mlehmann76/valvecontrol/hardware/revb/pdf/esp32control-B_Cu.pdf

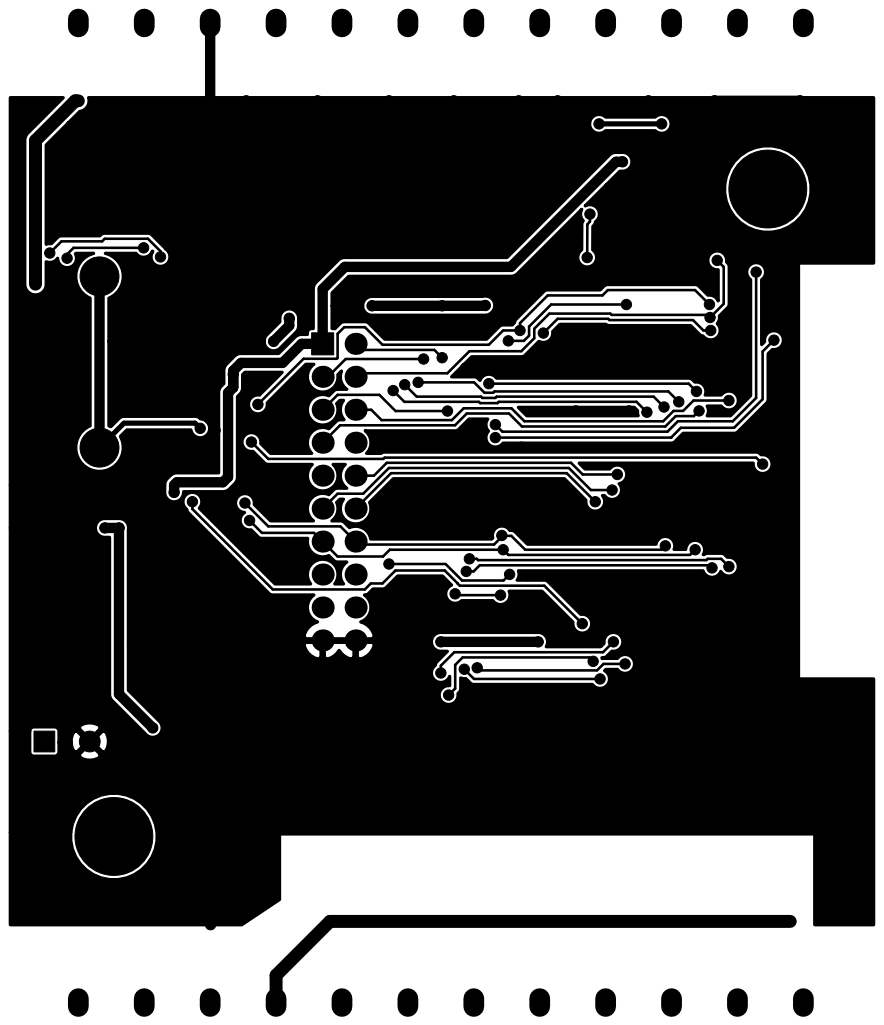
[picture p1: page 1]
