mlehmann76/valvecontrol/hardware/revb/pdf/esp32control-B_Mask.pdf

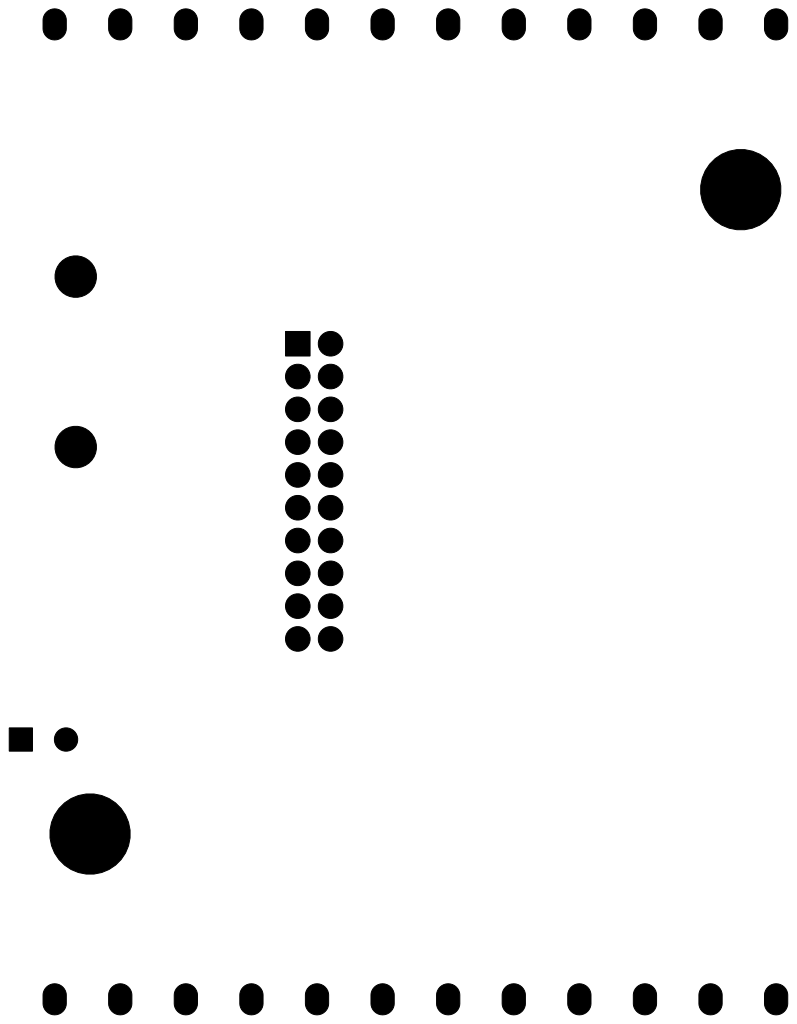
[picture p2: page 1]
