mlehmann76/valvecontrol/hardware/revb/pdf/esp32control-F_Cu.pdf

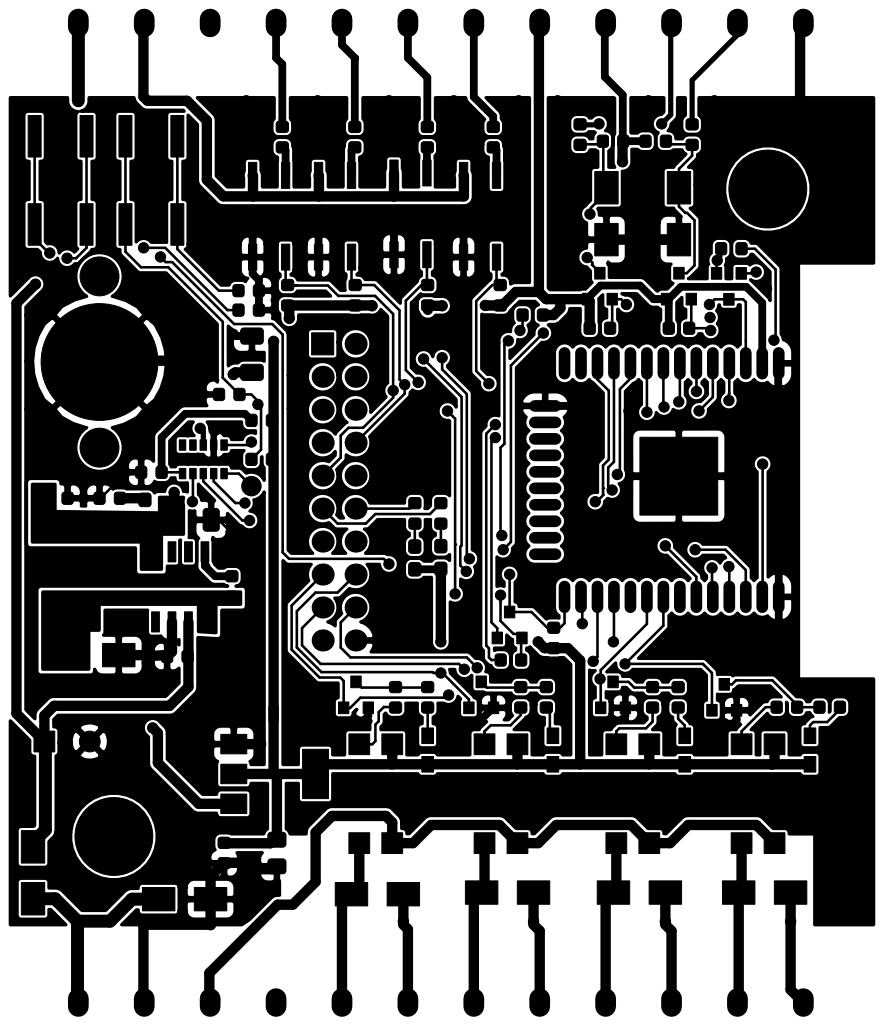
[picture p3: page 1]
