mlehmann76/valvecontrol/hardware/revb/pdf/esp32control-F_Mask.pdf

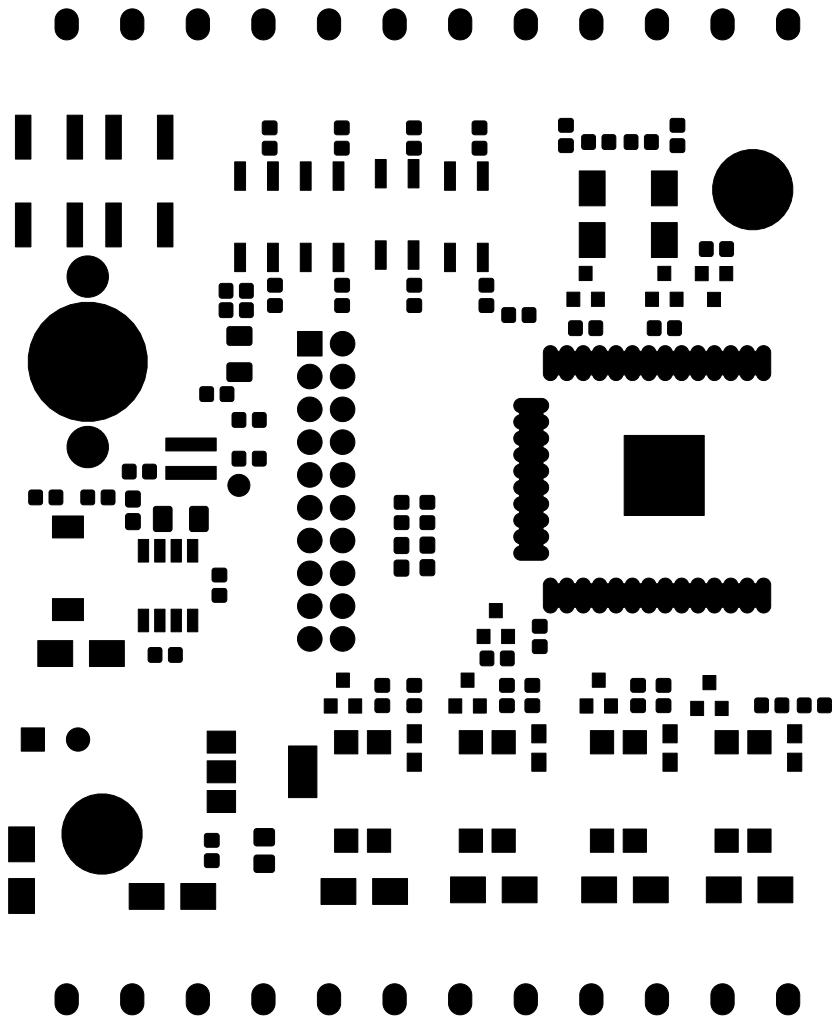
[picture p4: page 1]
