mlehmann76/valvecontrol/hardware/revb/pdf/esp32control-F_Paste.pdf

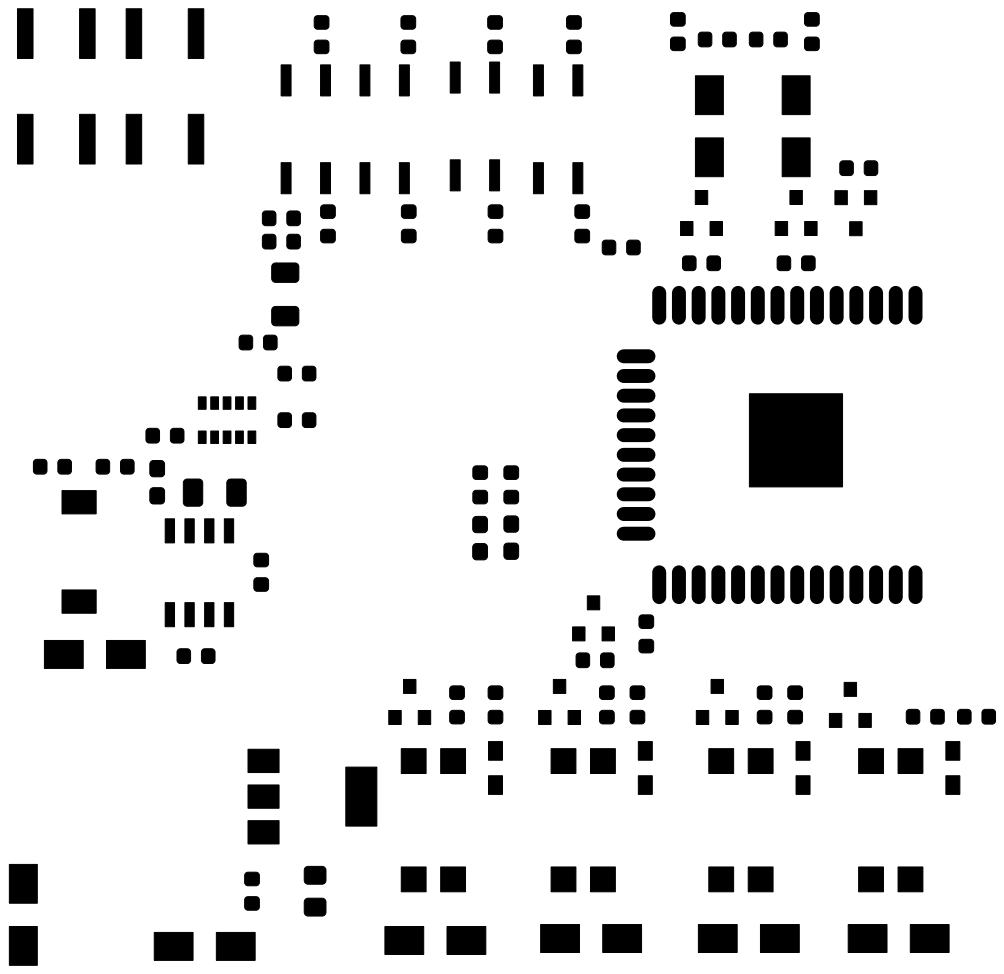
[picture p5: page 1]
