mlehmann76/valvecontrol/hardware/revb/pdf/esp32control-F_SilkS.pdf

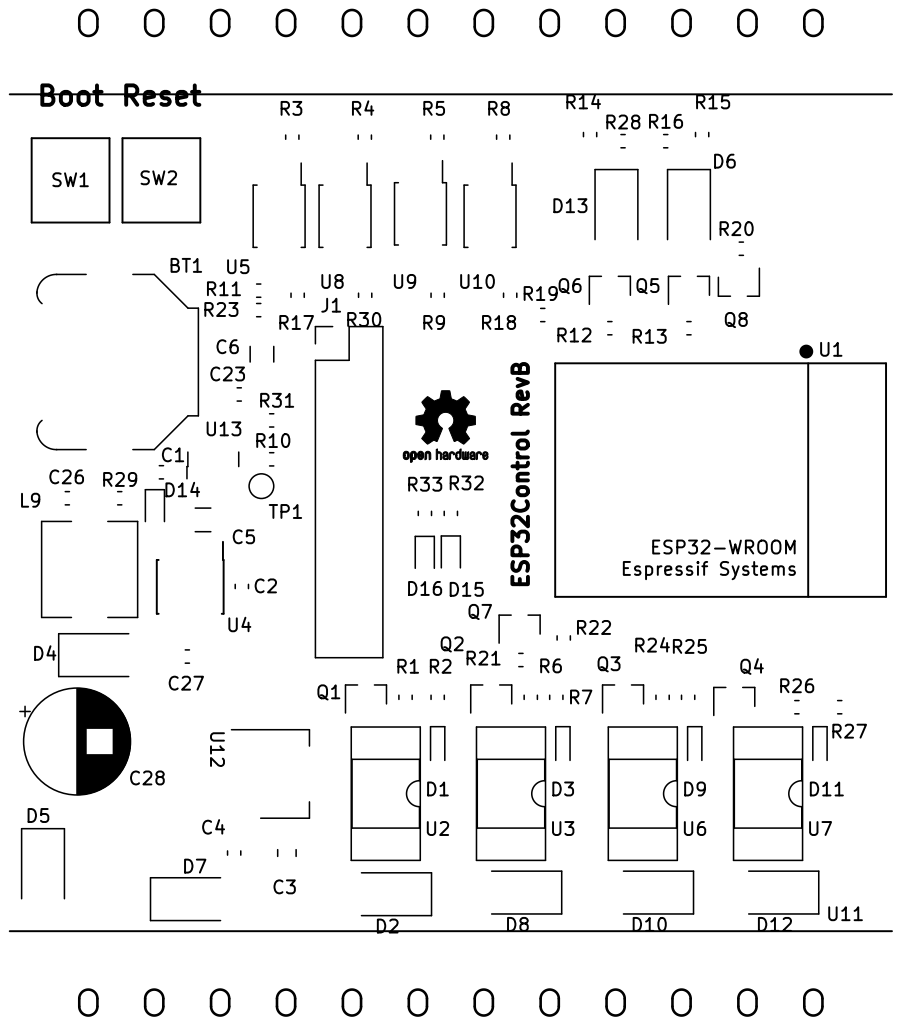
[picture p6: page 1]
