mlehmann76/valvecontrol/hardware/revc/esp32control.kicad_pcb

## KiCad design hardware/revc/esp32control.kicad_pcb (2023-11-15)

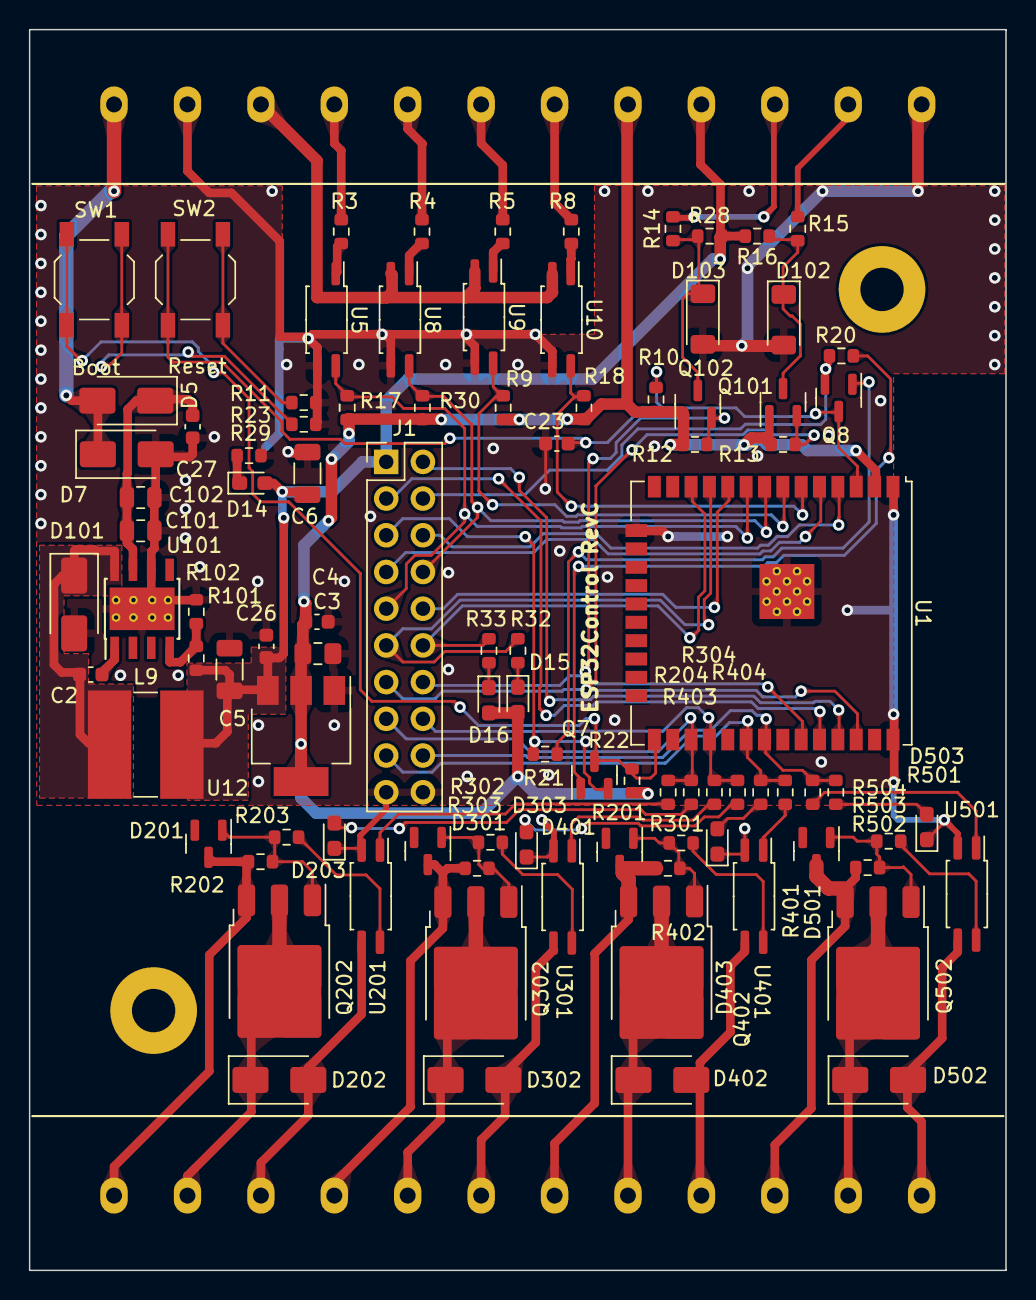
[picture p12: board hardware/revc/esp32control.kicad_pcb from above]

Board: 2 copper layers, 67.6 x 85.9 mm, 95 parts (0 on the bottom side), 77 nets.

Parts:
C2: 10n 50V; C_0603_1608Metric
C3: 10u 25V; C_0805_2012Metric_Pad1.18x1.45mm_HandSolder
C4, C26, C27: 100n 50V; C_0603_1608Metric
C5, C6: 47u 10V; C_1206_3216Metric
C23: 1u 25V; C_0603_1608Metric
C101, C102: 10u 50V; C_0805_2012Metric
D5, D101, D202, D302, D402, D502: SS34; D_SMA
D7: SMAJ26CAQ; D_SMA
D14, D15, D16, D203, D303, D403, D503: red; LED_0603_1608Metric_Pad1.05x0.95mm_HandSolder
D102, D103: ZMM5V6-M; D_MiniMELF
D201, D301, D401, D501: BZX84C10; SOT-23
J1: Conn_02x10_Odd_Even; PinHeader_2x10_P2.54mm_Vertical
L9: 22u; L_Ferrocore_DLG-0705
Q7, Q8: MMBT3904; SOT-23
Q101, Q102: 2N7002; SOT-23
Q202, Q302, Q402, Q502: HSU4113; TO-252-3_TabPin2
R3, R4, R5, R8: 1k5; R_0603_1608Metric
R9, R10, R12, R13, R16, R17, R18, R20, R21, R22, R28, R30: 10k; R_0603_1608Metric
R11, R14, R15, R23: 100; R_0603_1608Metric
R29, R32, R33, R201, R202, R203, R204, R301, R302, R303, R304, R401, R402, R403, R404, R501, R502, R503, R504: 1k; R_0603_1608Metric
R101: 12k; R_0603_1608Metric
R102: 3k9; R_0603_1608Metric
SW1: Boot; SW_SPST_TL3342
SW2: Reset; SW_SPST_TL3342
U1: ESP32-WROOM; ESP32-WROOM-32UE
U5, U8, U9, U10, U201, U301, U401, U501: EL3H7; SOP-4_4.4x2.6mm_P1.27mm
U11: HUT4; CB_HUT_4
U12: AMS1117-3.3; SOT-223-3_TabPin2
U101: TPS5430DDA; TI_SO-PowerPAD-8_ThermalVias

Connections:
+3V3: C3.1, C4.1, D15.2 (A), D16.2 (A), Q101.1 (G), Q102.1 (G), R9.2, R10.2, R12.2, R13.2, R17.2, R18.2, R22.2, R30.2, U1.2 (3V3), U11.20, U12.2 (VO)
+5V: C5.1, C6.1, C26.1, D14.2 (A), J1.1, L9.2, R16.2, R28.2, R101.1, U11.21, U12.3 (VI)
+24V: C27.1, C101.1, C102.1, D5.1 (K), U101.7 (VIN)
/CH1: J1.15, R201.2, R204.2, U1.27 (IO16)
/CH2: J1.16, R301.2, R304.2, U1.28 (IO17)
/CH3: J1.17, R401.2, R404.2, U1.30 (IO18)
/CH4: J1.18, R501.2, R504.2, U1.31 (IO19)
/DTR: J1.5, Q7.2 (E), R21.1
/IN1: R3.2, U11.16
/IN2: R4.2, U11.17
/IN3: R5.2, U11.18
/IN4: R8.2, U11.19
/IO25: J1.10, U1.10 (IO25)
/IO26: J1.11, R32.1, U1.11 (IO26)
/IO27: J1.12, R33.1, U1.12 (IO27)
/IO32: J1.8, R30.1, U1.8 (IO32), U8.4
/IO33: J1.9, R17.1, U1.9 (IO33), U5.4
/IO34: R18.1, U1.6 (IO34), U10.4
/IO35: R9.1, U1.7 (IO35), U9.4
/IO36: J1.6, U1.4 (SENSOR_VP)
/IO39: J1.7, U1.5 (SENSOR_VN)
/OUT1: D202.1 (K), Q202.2 (D), U11.2
/OUT2: D302.1 (K), Q302.2 (D), U11.5
/OUT3: D402.1 (K), Q402.2 (D), U11.8
/OUT4: D502.1 (K), Q502.2 (D), U11.11
/PH: C2.2, D101.1 (K), L9.1, U101.8 (PH)
/RTS: J1.4, Q8.2 (E), R20.1
/RXD0: J1.3, U1.34 (RXD0)
/SCL: J1.13, Q101.2 (S), R13.1, U1.36 (IO22)
/SCL_EXT: D102.1 (K), Q101.3 (D), R15.1, R16.1
/SDA: J1.14, Q102.2 (S), R12.1, U1.33 (IO21)
/SDA_EXT: D103.1 (K), Q102.3 (D), R14.1, R28.1
/TXD0: J1.2, U1.35 (TXD0)
/dig_output/GNDA: D202.2 (A), U11.3, U201.3
/dig_output/Vin: D201.3 (K), Q202.3 (S), R202.1, U11.1
/nBoot: Q7.3 (C), R22.1, SW1.2, U1.25 (IO0)
/nReset: C23.1, Q8.3 (C), R10.1, SW2.2, U1.3 (EN)
/sheet5C1F9DE2/GNDA: D402.2 (A), U11.9, U401.3
/sheet5C1F9DE2/Vin: D401.3 (K), Q402.3 (S), R402.1, U11.7
/sheet5C1F9DE3/GNDA: D502.2 (A), U11.12, U501.3
/sheet5C1F9DE3/Vin: D501.3 (K), Q502.3 (S), R502.1, U11.10
/sheet5C1F370F/GNDA: D302.2 (A), U11.6, U301.3
/sheet5C1F370F/Vin: D301.3 (K), Q302.3 (S), R302.1, U11.4
GND: C3.2, C4.2, C5.2, C6.2, C23.2, C26.2, C27.2, C101.2, C102.2, D7.2, D101.2 (A), D102.2 (A), D103.2 (A), D203.1 (K), D303.1 (K), D403.1 (K), D503.1 (K), J1.19, J1.20, R11.2, R23.2, R29.1, R102.2, U1.1 (GND), U1.15 (GND), U1.38 (GND), U1.39 (GND-PAD), U5.3, U8.3, U9.3, U10.3, U11.14, U11.24, U12.1 (GND), U101.6 (GND), U101.9 (GNDPAD), U201.2, U301.2, U401.2, U501.2
unnamed: D14.1 (K), R29.2
unnamed: D15.1 (K), R32.2
unnamed: D16.1 (K), R33.2
unnamed: D201.1 (A), Q202.1 (G), R202.2, R203.2
unnamed: D203.2 (A), R204.1
unnamed: D301.1 (A), Q302.1 (G), R302.2, R303.2
unnamed: D303.2 (A), R304.1
unnamed: D401.1 (A), Q402.1 (G), R402.2, R403.2
unnamed: D403.2 (A), R404.1
unnamed: D501.1 (A), Q502.1 (G), R502.2, R503.2
unnamed: D503.2 (A), R504.1
unnamed: Q7.1 (B), R20.2
unnamed: Q8.1 (B), R21.2
unnamed: R3.1, U5.1
unnamed: R4.1, U8.1
unnamed: R5.1, U9.1
unnamed: R8.1, U10.1
unnamed: R11.1, SW2.1
unnamed: R14.2, U11.22
unnamed: R15.2, U11.23
unnamed: R23.1, SW1.1
unnamed: R201.1, U201.1
unnamed: R203.1, U201.4
unnamed: R301.1, U301.1
unnamed: R303.1, U301.4
unnamed: R401.1, U401.1
unnamed: R403.1, U401.4
unnamed: R501.1, U501.1
unnamed: R503.1, U501.4
unnamed: C2.1, U101.1 (BOOT)
unnamed: R101.2, R102.1, U101.4 (VSENSE)
VCOM: U5.2, U8.2, U9.2, U10.2, U11.15
VD: D5.2 (A), D7.1, U11.13
