mlehmann76/valvecontrol/hardware/revb/esp32control.kicad_pcb

## KiCad design hardware/revb/esp32control.kicad_pcb (2022-08-18, an earlier design)

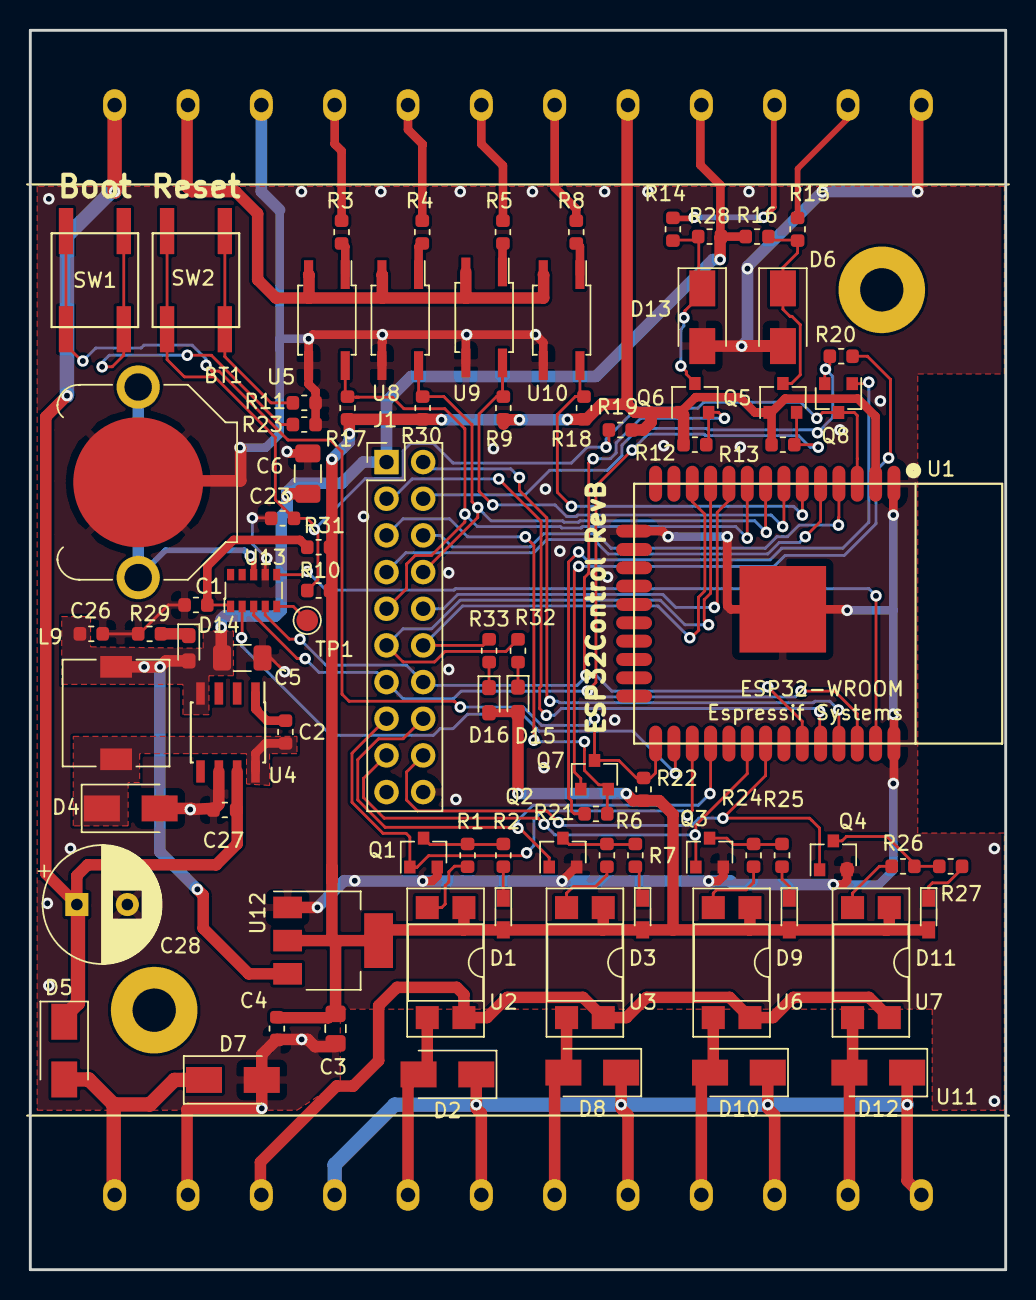
[picture p13: board hardware/revb/esp32control.kicad_pcb from above]

Board: 2 copper layers, 67.6 x 85.9 mm, 86 parts (0 on the bottom side), 71 nets.

Parts:
BT1: Battery_Cell; BatteryHolder_Keystone_3001_1x12mm
C1, C23: 1u; C_0603_1608Metric
C2: 10n; C_0603_1608Metric
C3: 4u7; C_0805_2012Metric_Pad1.15x1.40mm_HandSolder
C4, C26, C27: 100n; C_0603_1608Metric
C5, C6: 47u 10V; C_1206_3216Metric
C28: 100u 50V; CP_Radial_D8.0mm_P3.50mm
D1, D3, D9, D11: LED; LED_0603_HandSoldering
D2, D7, D8, D10, D12: SMAJ26CAQ; D_SMA
D4, D5: MBRS140; D_SMA
D6, D13: SMAZ7V5; D_SMA
D14, D15, D16: LED; LED_0603_1608Metric_Pad1.05x0.95mm_HandSolder
J1: Conn_02x10_Odd_Even; PinHeader_2x10_P2.54mm_Vertical
L9: 680u; L_7.3x7.3_H4.5
Q1, Q2, Q3, Q4, Q5, Q6: BSS138; SOT-23
Q7, Q8: MMBT3904; SOT-23
R1, R2, R6, R7, R24, R25, R26, R27, R29, R32, R33: 1k; R_0603_1608Metric
R3, R4, R5, R8: 1k5; R_0603_1608Metric
R9, R10, R12, R13, R16, R17, R18, R19, R20, R21, R22, R28, R30: 10k; R_0603_1608Metric
R11, R14, R15, R23, R31: 100; R_0603_1608Metric
SW1: Boot; SMD_Switch_6.5x6
SW2: Reset; SMD_Switch_6.5x6
TP1: TestPoint; TestPoint_Pad_D1.5mm
U1: ESP32-WROOM
U2, U3, U6, U7: AQY212; DIP-4_W7.62mm_SMDSocket_SmallPads
U4: LM2675M-5; SOIC-8_3.9x4.9mm_Pitch1.27mm
U5, U8, U9, U10: LTV-354T; SO-4_4.4x3.6mm_Pitch2.54mm
U11: HUT4; CB_HUT_4
U12: LM1117-3.3; SOT-223-3_TabPin2
U13: RV-8523-C3; RTC_SMD_MicroCrystal_C3_2.5x3.7mm

Connections:
+3V3: C3.1, C4.1, D1.2, D3.2, D9.2, D11.2, D15.2, D16.2, Q5.1, Q6.1, R9.2, R10.2, R12.2, R13.2, R17.2, R18.2, R19.1, R22.2, R30.2, R31.1, U1.2, U2.1, U3.1, U6.1, U7.1, U11.20, U12.2
+5V: C5.1, C6.1, C26.1, D14.2, J1.1, L9.2, R16.2, R28.2, U4.4, U11.21, U12.3
+24V: C27.1, C28.1, D5.1, U4.7, U11.13
/CH1: J1.15, Q1.1, U1.27
/CH2: J1.16, Q2.1, U1.28
/CH3: J1.17, Q3.1, U1.30
/CH4: J1.18, Q4.1, U1.31
/DTR: J1.5, Q7.2, R21.1
/IN1: R3.2, U11.16
/IN2: R4.2, U11.17
/IN3: R5.2, U11.18
/IN4: R8.2, U11.19
/IO4: U1.26, U13.2
/IO23: U1.37, U13.6
/IO25: J1.10, U1.10
/IO26: J1.11, R32.1, U1.11
/IO27: J1.12, R33.1, U1.12
/IO32: J1.8, R30.1, U1.8, U8.4
/IO33: J1.9, R17.1, U1.9, U5.4
/IO36: J1.6, U1.4
/IO39: J1.7, U1.5
/OPTO3: R9.1, U1.7, U9.4
/OPTO4: R18.1, U1.6, U10.4
/OUT1: D2.2, U2.3, U11.5
/OUT2: D8.2, U3.3, U11.7
/OUT3: D10.2, U6.3, U11.9
/OUT4: D12.2, U7.3, U11.11
/RTS: J1.4, Q8.2, R20.1
/RXD0: J1.3, U1.34
/SCL: J1.13, Q5.2, R13.1, U1.36, U13.3
/SCL_EXT: D6.1, Q5.3, R15.1, R16.1
/SDA: J1.14, Q6.2, R12.1, U1.33, U13.4
/SDA_EXT: D13.1, Q6.3, R14.1, R28.1
/TXD0: J1.2, U1.35
/VREF: U2.4, U3.4, U6.4, U7.4, U11.3
/Vin: D5.2, D7.1, U11.1
/nBoot: Q7.3, R22.1, SW1.B, SW1.B', U1.25
/nReset: C23.1, Q8.3, R10.1, R19.2, SW2.B, SW2.B', U1.3
GND: BT1.2, C1.2, C3.2, C4.2, C5.2, C6.2, C23.2, C26.2, C27.2, C28.2, D4.2, D6.2, D7.2, D13.2, J1.19, J1.20, Q1.2, Q2.2, Q3.2, Q4.2, R11.2, R23.2, R29.1, U1.1, U1.15, U1.38, U1.39, U4.6, U5.3, U8.3, U9.3, U10.3, U11.2, U11.15, U11.24, U12.1, U13.7
GNDA: D2.1, D8.1, D10.1, D12.1, U11.4, U11.6, U11.8, U11.10, U11.12
unnamed: BT1.1, U13.8
unnamed: C1.1, R31.2, U13.1
unnamed: C2.1, U4.1
unnamed: C2.2, D4.1, L9.1, U4.8
unnamed: D1.1, R2.1
unnamed: D3.1, R7.1
unnamed: D9.1, R25.1
unnamed: D11.1, R27.1
unnamed: D14.1, R29.2
unnamed: D15.1, R32.2
unnamed: D16.1, R33.2
unnamed: Q1.3, R1.1, R2.2
unnamed: Q2.3, R6.1, R7.2
unnamed: Q3.3, R24.1, R25.2
unnamed: Q4.3, R26.1, R27.2
unnamed: Q7.1, R20.2
unnamed: Q8.1, R21.2
unnamed: R1.2, U2.2
unnamed: R3.1, U5.1
unnamed: R4.1, U8.1
unnamed: R5.1, U9.1
unnamed: R6.2, U3.2
unnamed: R8.1, U10.1
unnamed: R11.1, SW2.A, SW2.A'
unnamed: R14.2, U11.22
unnamed: R15.2, U11.23
unnamed: R23.1, SW1.A, SW1.A'
unnamed: R24.2, U6.2
unnamed: R26.2, U7.2
unnamed: TP1.1, U13.5
VCOM: U5.2, U8.2, U9.2, U10.2, U11.14
