mlehmann76/valvecontrol/(commit log)

2018-05-11 change to esp32mqtt
2018-05-12 corrected pin names according to hardware bug in gpiotask, changed updateGpio change status messages to son/soff to prevent false enabling enabled reboot on panic
    [mqtt_publish_main.c]
2018-08-17 esp32ValveControl hardware initial
    [esp32ValveControl.kicad_pcb, esp32ValveControl.sch]
2018-08-21 schem_/pcb update
    [esp32ValveControl.kicad_pcb, esp32ValveControl.sch]
2018-10-13 hardware update
    [esp32ValveControl.kicad_pcb, esp32ValveControl.sch]
2018-10-31 refaktor, cleanup, added wps button short/long detect
2018-12-16 libs update
    [esp32ValveControl.kicad_pcb, esp32ValveControl.sch]
2018-12-25 hier. schematic updates
    [digOutputSingleIso.sch, dig_output.sch, esp32ValveControl.sch]
2018-12-28 route and fab files
    [digOutputSingleIso.sch, dig_output.sch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]
2019-04-01 pcb update
    [dig_output.sch, esp32control.kicad_pcb, esp32control.sch]
2019-04-03 updated sch & pcb
    [esp32control.kicad_pcb, esp32control.sch]
2020-03-28 update libs to kicad 5.1.5
    [dig_output.sch, esp32control.kicad_pcb, esp32control.sch]
2020-03-30 silk update, fab files regen, pdf added
    [esp32control-B_Cu.gbl, esp32control-B_Mask.gbs, esp32control-B_Paste.gbp, esp32control-B_SilkS.gbo, esp32control-Edge_Cuts.gm1, esp32control-F_Cu.gtl, esp32control-F_Mask.gts, esp32control-F_Paste.gtp]
2020-05-21 revB initial
    [dig_output.sch, esp32control.kicad_pcb, esp32control.sch]
2020-05-22 pcb update, fab generated
    [esp32control-B.Cu.gbl, esp32control-B.Mask.gbs, esp32control-B.SilkS.gbo, esp32control-B_Cu.gbl, esp32control-B_Mask.gbs, esp32control-B_Paste.gbp, esp32control-B_SilkS.gbo, esp32control-Edge.Cuts.gm1]
2020-05-23 added pdf outputs, regen fab
    [esp32control-B_Cu.gbl, esp32control-B_Mask.gbs, esp32control-B_Paste.gbp, esp32control-B_SilkS.gbo, esp32control-Edge_Cuts.gm1, esp32control-F_Cu.gtl, esp32control-F_Mask.gts, esp32control-F_Paste.gtp]
2020-05-23 changed gerber output to jlcpcb format
    [esp32control-B_Cu.gbl, esp32control-B_Mask.gbs, esp32control-B_Paste.gbp, esp32control-B_SilkS.gbo, esp32control-Edge_Cuts.gm1, esp32control-F_Cu.gtl, esp32control-F_Mask.gts, esp32control-F_Paste.gtp]
2020-05-24 switched position of con and esp in layout
    [dig_output.sch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]
2020-05-24 moved via out of pad
    [esp32control-B_Cu.gbl, esp32control-B_Mask.gbs, esp32control-B_Paste.gbp, esp32control-B_SilkS.gbo, esp32control-Edge_Cuts.gm1, esp32control-F_Cu.gtl, esp32control-F_Mask.gts, esp32control-F_Paste.gtp]
2020-05-24 corrected silk screen
    [esp32control-B_Cu.gbl, esp32control-B_Mask.gbs, esp32control-B_Paste.gbp, esp32control-B_SilkS.gbo, esp32control-Edge_Cuts.gm1, esp32control-F_Cu.gtl, esp32control-F_Mask.gts, esp32control-F_Paste.gtp]
2020-06-05 bom update
    [dig_output.sch, esp32control.csv, esp32control.kicad_pcb, esp32control.sch]
2022-08-18 kicad6 update
    [dig_output.kicad_sch, dig_output.sch, esp32control.csv, esp32control.kicad_pcb, esp32control.kicad_sch, esp32control.sch]
2023-11-12 renamed hw to revb
    [digOutputSingleIso.sch, dig_output.kicad_sch, dig_output.sch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]
2023-11-15 workflow fix (#2)
    * remove inner layer in yaml
    * fixed erc
    * fixed drc
    * updated wroom32 fp
    * updated kibot
    * updated pcb
    * updated pcb
    * updated yml
    * yml updates
    * fixed layer entries
    * updated sch, pcb, bom
    * reduced drc verbosity
    [dig_output.kicad_sch, esp32control.kicad_pcb, esp32control.kicad_sch]
